haShinui/usb_pd/KiCad Files/HUSB238_3.3V_Version/HUSB238_3.3V_Version.kicad_pcb

## KiCad design KiCad Files/HUSB238_3.3V_Version/HUSB238_3.3V_Version.kicad_pcb (2025-05-15)

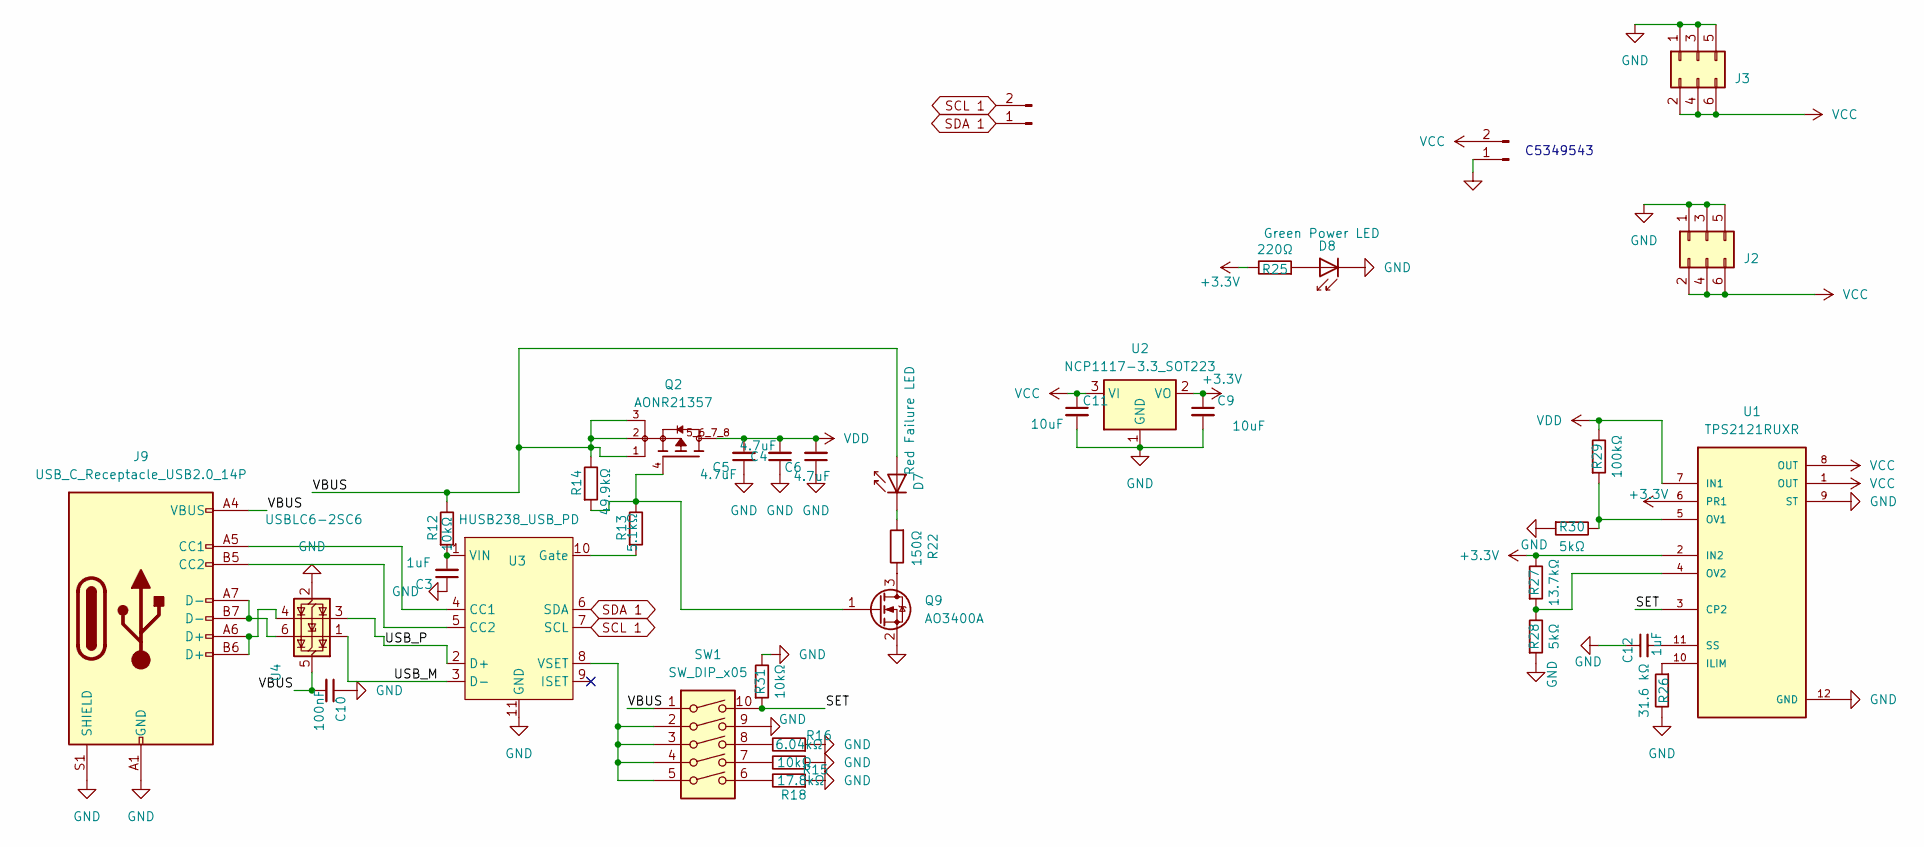
[picture p3: schematic HUSB238_3.3V_Version.kicad_sch]

Parts:
C3, C12: 1uF; C_0402_1005Metric_Pad0.74x0.62mm_HandSolder
C4, C5, C6: 4.7uF; C_0402_1005Metric_Pad0.74x0.62mm_HandSolder
C9, C11: 10uF; C_0402_1005Metric_Pad0.74x0.62mm_HandSolder
C10: 100nF; C_0402_1005Metric_Pad0.74x0.62mm_HandSolder
D7: Red Failure LED; LED_0603_1608Metric_Pad1.05x0.95mm_HandSolder
D8: Green Power LED; LED_0603_1608Metric_Pad1.05x0.95mm_HandSolder
J2, J3: Conn_02x02_Counter_Clockwise; PinHeader_2x03_P2.54mm_Vertical_SMD
J4: Conn_01x02_Pin; TerminalBlock_TE_282834-2_1x02_P2.54mm_Horizontal
J9: USB_C_Receptacle_USB2.0_14P; USB_C_Receptacle_XKB_U262-16XN-4BVC11
N21: Conn_01x02_Pin; PinHeader_1x02_P2.54mm_Vertical
Q2: AONR21357; TRANS_AONR21307; PARTREV 1.1
Q9: AO3400A; SOT-23
R12, R15, R31: 10kΩ; R_0402_1005Metric_Pad0.72x0.64mm_HandSolder
R13: 5.1kΩ; R_0402_1005Metric_Pad0.72x0.64mm_HandSolder
R14: 49.9kΩ; R_0402_1005Metric_Pad0.72x0.64mm_HandSolder
R16: 6.04kΩ; R_0402_1005Metric_Pad0.72x0.64mm_HandSolder
R18: 17.8kΩ; R_0402_1005Metric_Pad0.72x0.64mm_HandSolder
R22: 150Ω; R_0402_1005Metric_Pad0.72x0.64mm_HandSolder
R25: 220Ω; R_0402_1005Metric_Pad0.72x0.64mm_HandSolder
R26: 31.6 kΩ; R_0402_1005Metric_Pad0.72x0.64mm_HandSolder
R27: 13.7kΩ; R_0402_1005Metric_Pad0.72x0.64mm_HandSolder
R28, R30: 5kΩ; R_0402_1005Metric_Pad0.72x0.64mm_HandSolder
R29: 100kΩ; R_0402_1005Metric_Pad0.72x0.64mm_HandSolder
SW1: SW_DIP_x05; SW_DIP_SPSTx05_Slide_6.7x14.26mm_W8.61mm_P2.54mm_LowProfile
U1: TPS2121RUXR; IC_TPS2121RUXR
U2: NCP1117-3.3_SOT223; SOT-223-3_TabPin2
U3: HUSB238_USB_PD; DFN-10-1EP_3x3mm_P0.5mm_EP1.55x2.48mm
U4: USBLC6-2SC6; SOT-23-6

Connections:
+3.3V: C9.1, R25.2, R27.2, U1.2 (IN2), U1.6 (PR1), U2.2 (VO)
/SET: R31.1, SW1.10, U1.3 (CP2)
/USB_M: U3.3 (D-), U4.1 (I/O1)
/USB_P: U3.2 (D+), U4.3 (I/O2)
/VBUS: C10.2, D7.2 (A), J9.A4 (VBUS), J9.A9 (VBUS), J9.B4 (VBUS), J9.B9 (VBUS), Q2.1, Q2.2, Q2.3, R12.2, R14.2, SW1.1, U4.5 (VBUS)
GND: C3.1, C4.1, C5.1, C6.1, C9.2, C10.1, C11.2, C12.1, D8.1 (K), J2.1, J2.3, J2.5, J3.1, J3.3, J3.5, J4.1, J9.A1 (GND), J9.A12 (GND), J9.B1 (GND), J9.B12 (GND), J9.S1 (SHIELD), Q9.2 (S), R15.1, R16.1, R18.1, R26.2, R28.1, R30.1, R31.2, SW1.9, U1.9 (ST), U1.12 (GND), U2.1 (GND), U3.11 (GND), U4.2 (GND)
unnamed: D7.1 (K), R22.1
unnamed: D8.2 (A), R25.1
unnamed: J9.A5 (CC1), U3.4 (CC1)
unnamed: J9.B5 (CC2), U3.5 (CC2)
unnamed: J9.A6 (D+), J9.B6 (D+), U4.4 (I/O2)
unnamed: J9.A7 (D-), J9.B7 (D-), U4.6 (I/O1)
unnamed: Q9.3 (D), R22.2
unnamed: Q2.4, Q9.1 (G), R13.2, R14.1
unnamed: R15.2, SW1.7
unnamed: R16.2, SW1.8
unnamed: R18.2, SW1.6
unnamed: R26.1, U1.10 (ILIM)
unnamed: R29.1, R30.2, U1.5 (OV1)
unnamed: R27.1, R28.2, U1.4 (OV2)
unnamed: C12.2, U1.11 (SS)
unnamed: R13.1, U3.10 (Gate)
unnamed: C3.2, R12.1, U3.1 (VIN)
unnamed: SW1.2, SW1.3, SW1.4, SW1.5, U3.8 (VSET)
SCL 1: N21.2, U3.7 (SCL)
SDA 1: N21.1, U3.6 (SDA)
VCC: C11.1, J2.2, J2.4, J2.6, J3.2, J3.4, J3.6, J4.2, U1.1 (OUT), U1.8 (OUT), U2.3 (VI)
VDD: C4.2, C5.2, C6.2, Q2.5_6_7_8, R29.2, U1.7 (IN1)

Notes on the sheet:
C5349543

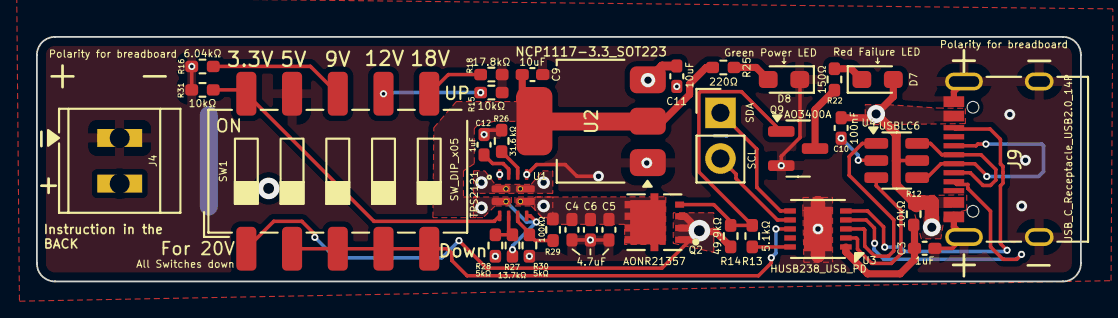
[picture p4: board HUSB238_3.3V_Version.kicad_pcb from above]

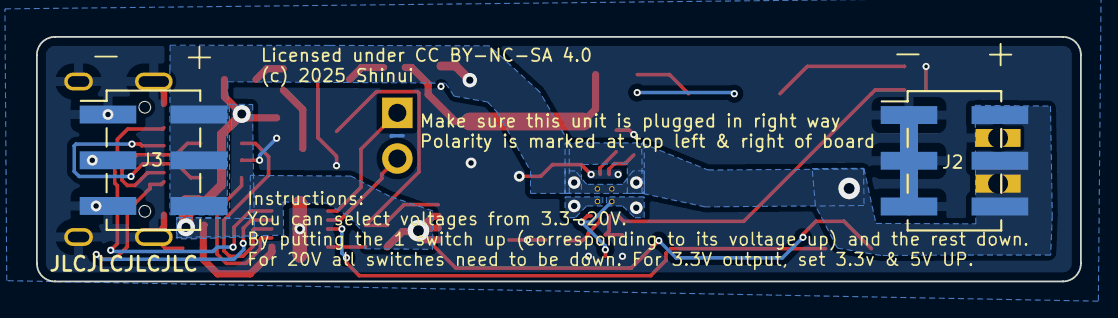
[picture p5: board HUSB238_3.3V_Version.kicad_pcb from below]

Board: 2 copper layers, 58.0 x 13.6 mm, 36 parts (2 on the bottom side), 28 nets.
