haShinui/usb_pd/KiCad Files/BrodBoost-PD.kicad_pcb

## KiCad design KiCad Files/BrodBoost-PD.kicad_pcb (2025-05-07)

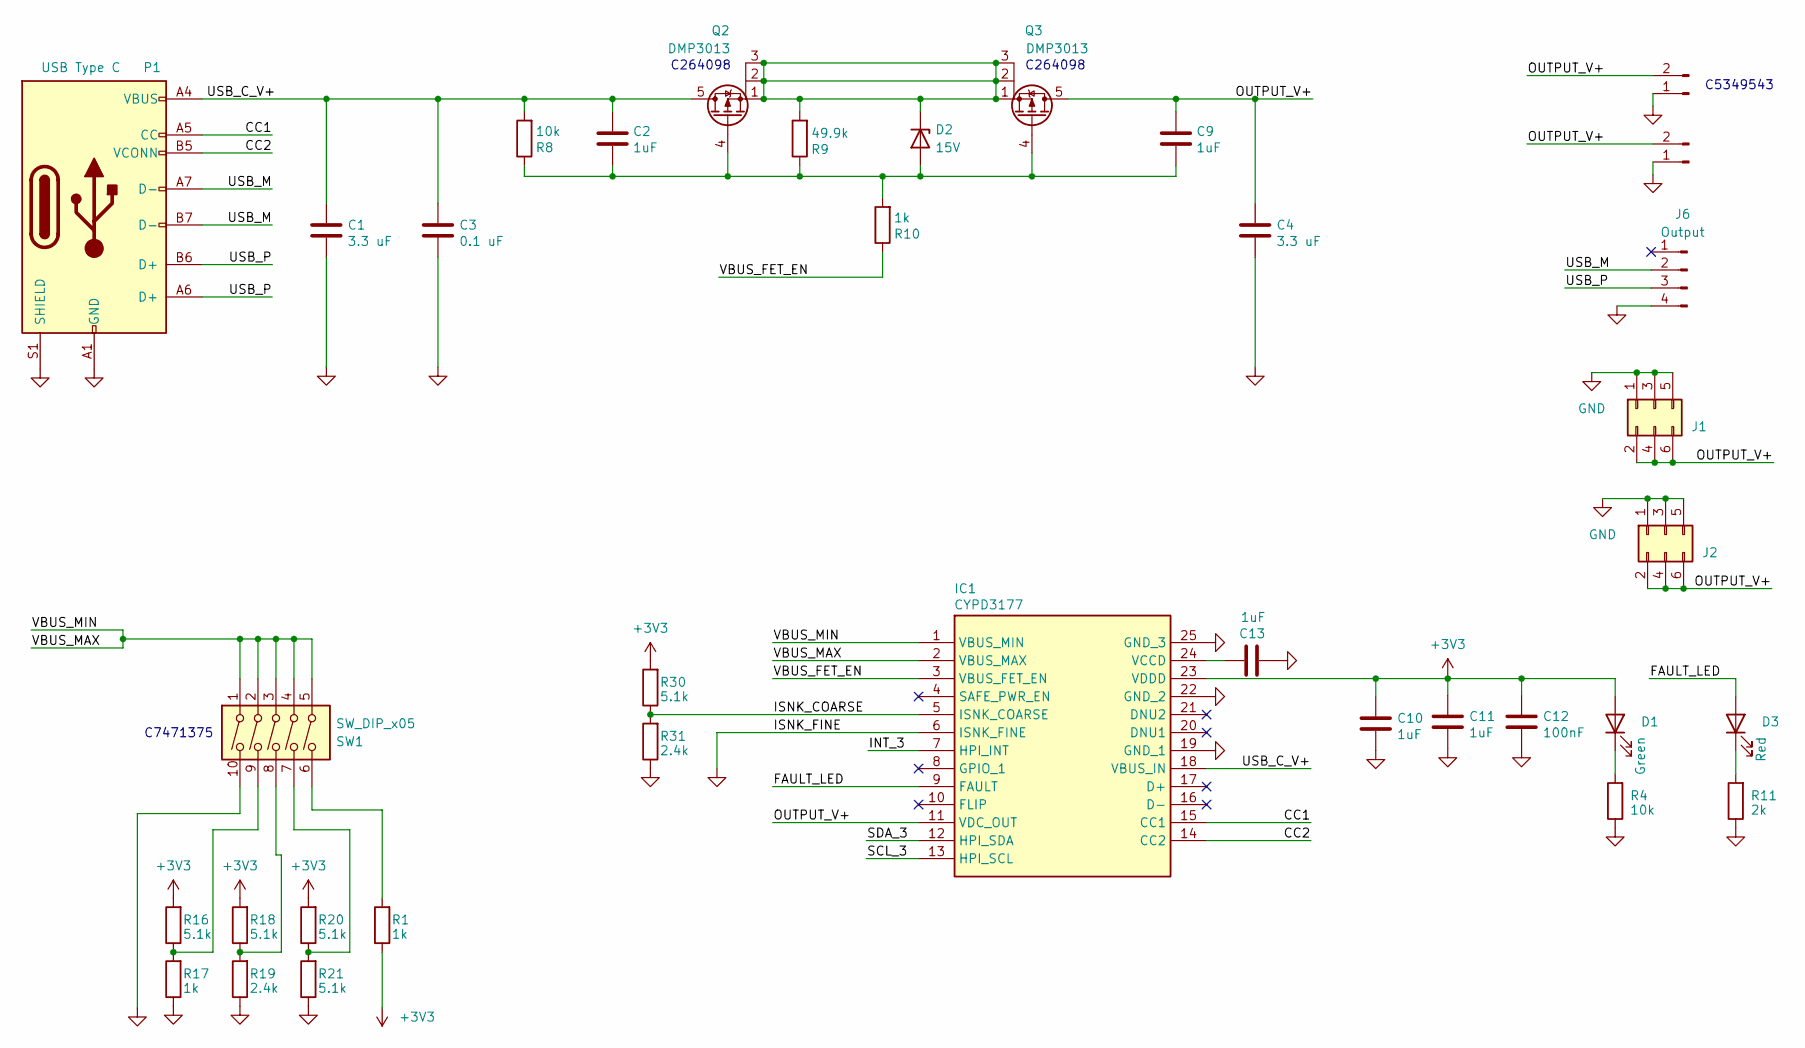
[picture p6: schematic BrodBoost-PD.kicad_sch]

Parts:
C1, C4: 3.3 uF; C_0603_1608Metric; JLCPCB C14663
C2, C9, C10, C11, C13: 1uF; C_0402_1005Metric; JLCPCB C14663
C3: 0.1 uF; C_0603_1608Metric; JLCPCB C14663
C12: 100nF; C_0402_1005Metric; JLCPCB C14663
D1: Green; LED_0603_1608Metric
D2: 15V; D_SOD-323F
D3: Red; LED_0603_1608Metric
IC1: CYPD3177; Mouser Part Number 727-CYPD3177-24LQXQ
J1, J2: Conn_02x02_Counter_Clockwise; PinHeader_2x03_P2.54mm_Vertical_SMD
J4: Conn_01x02_Pin; TerminalBlock_4Ucon_1x02_P3.50mm_Vertical
J6: Output; PinHeader_1x04_P2.54mm_Horizontal
N21: Conn_01x02_Pin; PinSocket_1x02_P2.54mm_Vertical_SMD_Pin1Left
P1: USB Type C; USB_C_Receptacle_HRO_TYPE-C-31-M-12
Q2, Q3: DMP3013; Diodes_PowerDI3333-8; Mfr PN DMP3013SFV
R1, R10, R17: 1k; R_0402_1005Metric
R4, R8: 10k; R_0402_1005Metric
R9: 49.9k; R_0402_1005Metric
R11: 2k; R_0402_1005Metric
R16, R18, R20, R21, R30: 5.1k; R_0402_1005Metric
R19, R31: 2.4k; R_0402_1005Metric
SW1: SW_DIP_x05; SW_DIP_SPSTx05_Slide_9.78x14.88mm_W8.61mm_P2.54mm

Connections:
+3V3: C10.1, C11.1, C12.1, D1.2 (A), IC1.23 (VDDD), R1.1, R16.2, R18.2, R20.2, R30.2
/CC1: IC1.15 (CC1), P1.A5 (CC)
/CC2: IC1.14 (CC2), P1.B5 (VCONN)
/FAULT_LED: D3.2 (A), IC1.9 (FAULT)
/INT_3: IC1.7 (HPI_INT)
/ISNK_COARSE: IC1.5 (ISNK_COARSE), R30.1, R31.2
/OUTPUT_V+: C4.1, C9.1, IC1.11 (VDC_OUT), J1.2, J1.4, J1.6, J2.2, J2.4, J2.6, J4.2, N21.2, Q3.5 (D)
/SCL_3: IC1.13 (HPI_SCL)
/SDA_3: IC1.12 (HPI_SDA)
/USB_C_V+: C1.1, C2.1, C3.1, IC1.18 (VBUS_IN), P1.A4 (VBUS), P1.A9 (VBUS), P1.B4 (VBUS), P1.B9 (VBUS), Q2.5 (D), R8.2
/USB_M: J6.2, P1.A7 (D-), P1.B7 (D-)
/USB_P: J6.3, P1.A6 (D+), P1.B6 (D+)
/VBUS_FET_EN: IC1.3 (VBUS_FET_EN), R10.1
/VBUS_MAX: IC1.1 (VBUS_MIN), IC1.2 (VBUS_MAX), SW1.1, SW1.2, SW1.3, SW1.4, SW1.5
GND: C1.2, C3.2, C4.2, C10.2, C11.2, C12.2, C13.2, IC1.6 (ISNK_FINE), IC1.19 (GND_1), IC1.22 (GND_2), IC1.25 (GND_3), J1.1, J1.3, J1.5, J2.1, J2.3, J2.5, J4.1, J6.4, N21.1, P1.A1 (GND), P1.A12 (GND), P1.B1 (GND), P1.B12 (GND), P1.S1 (SHIELD), R4.1, R11.1, R17.1, R19.1, R21.1, R31.1, SW1.10
unnamed: D1.1 (K), R4.2
unnamed: C2.2, C9.2, D2.2 (A), Q2.4 (G), Q3.4 (G), R8.1, R9.1, R10.2
unnamed: D2.1 (K), Q2.1 (S), Q2.2 (S), Q2.3 (S), Q3.1 (S), Q3.2 (S), Q3.3 (S), R9.2
unnamed: D3.1 (K), R11.2
unnamed: C13.1, IC1.24 (VCCD)
unnamed: R1.2, SW1.6
unnamed: R16.1, R17.2, SW1.9
unnamed: R18.1, R19.2, SW1.8
unnamed: R20.1, R21.2, SW1.7

Notes on the sheet:
C264098
C7471375
C5349543

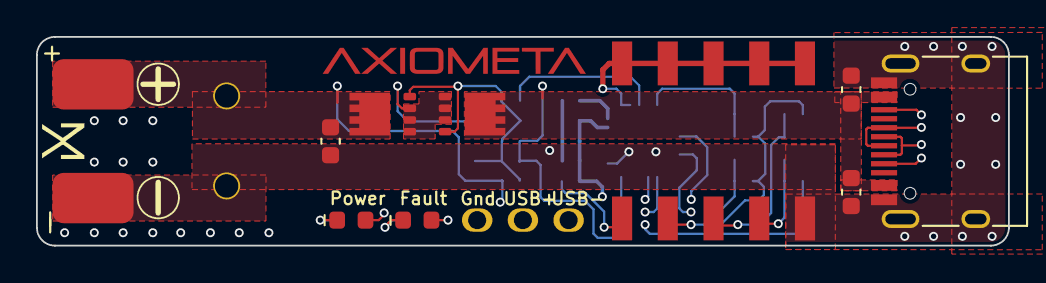
[picture p7: board BrodBoost-PD.kicad_pcb from above]

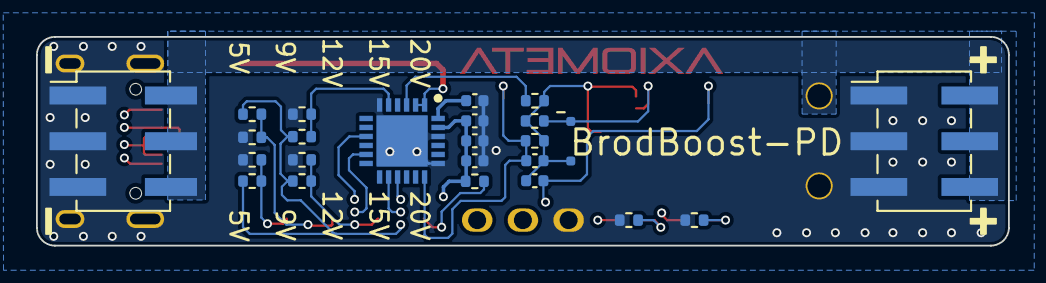
[picture p8: board BrodBoost-PD.kicad_pcb from below]

Board: 4 copper layers, 54.0 x 11.6 mm, 36 parts (24 on the bottom side), 21 nets.
