haShinui/usb_pd/(notices)

Notices in the files:
KiCad Files/CYPD3177_3.3V_V2_+_OLED/Power.kicad_sch:
Licensed under CC BY-NC-SA 4.0 (c) 2025 Shinui
KiCad Files/CYPD3177_3.3V_V2_+_OLED/CYPD3177_3.3V_V2_+_OLED(before via changes to 0.3mm).kicad_pcb:
(c) 2025 Shinui
parts and their libraries:
COPYRIGHT: Copyright (C) 2022 Ultra Librarian. All rights reserved.
